capnmidnight/GeblinkenKiosk/doc/kiosk.JPG

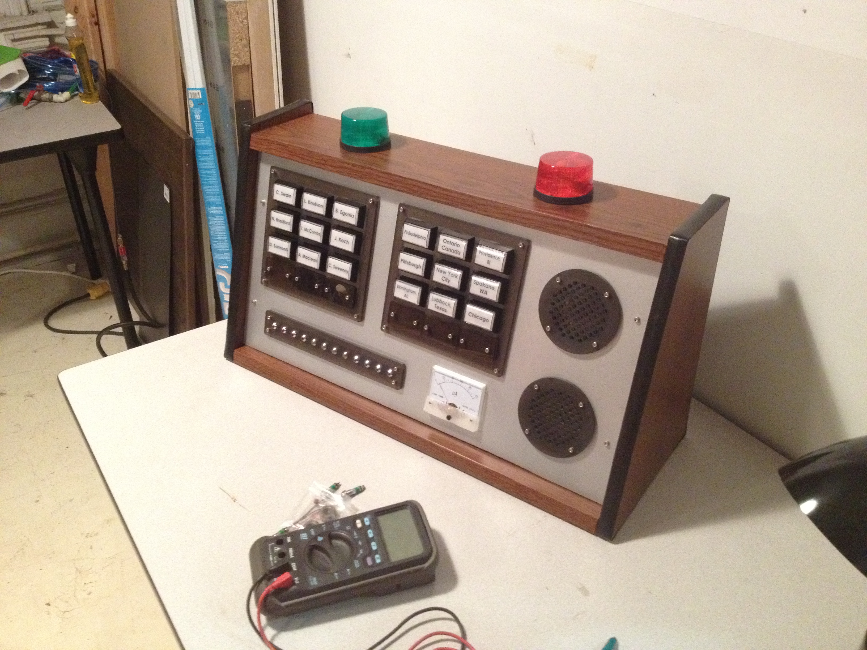
doc/kiosk.JPG
