capnmidnight/GeblinkenKiosk/doc/kiosk2.png

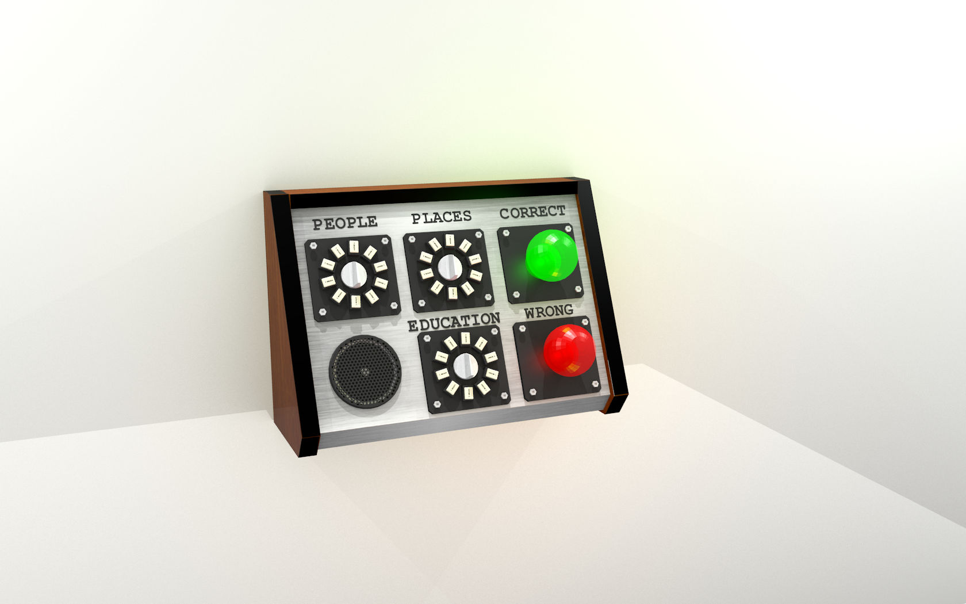
doc/kiosk2.png
