capnmidnight/GeblinkenKiosk/doc/kiosk1.png

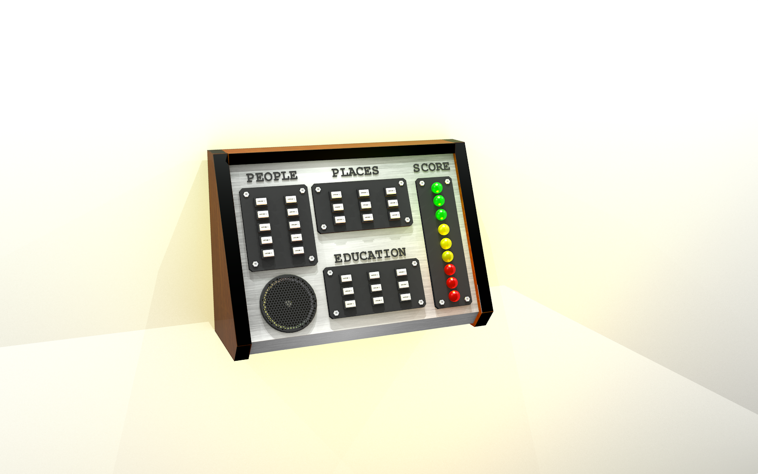
doc/kiosk1.png
