capnmidnight/GeblinkenKiosk/doc/kiosk3.png

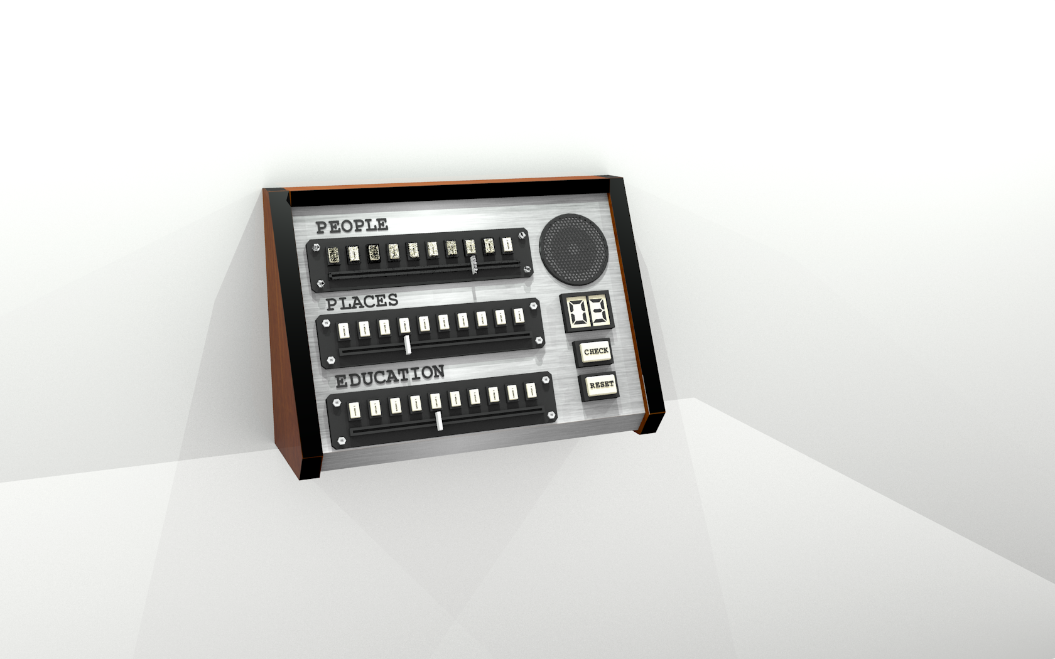
doc/kiosk3.png
