capnmidnight/GeblinkenKiosk/doc/mp3-kiosk.png

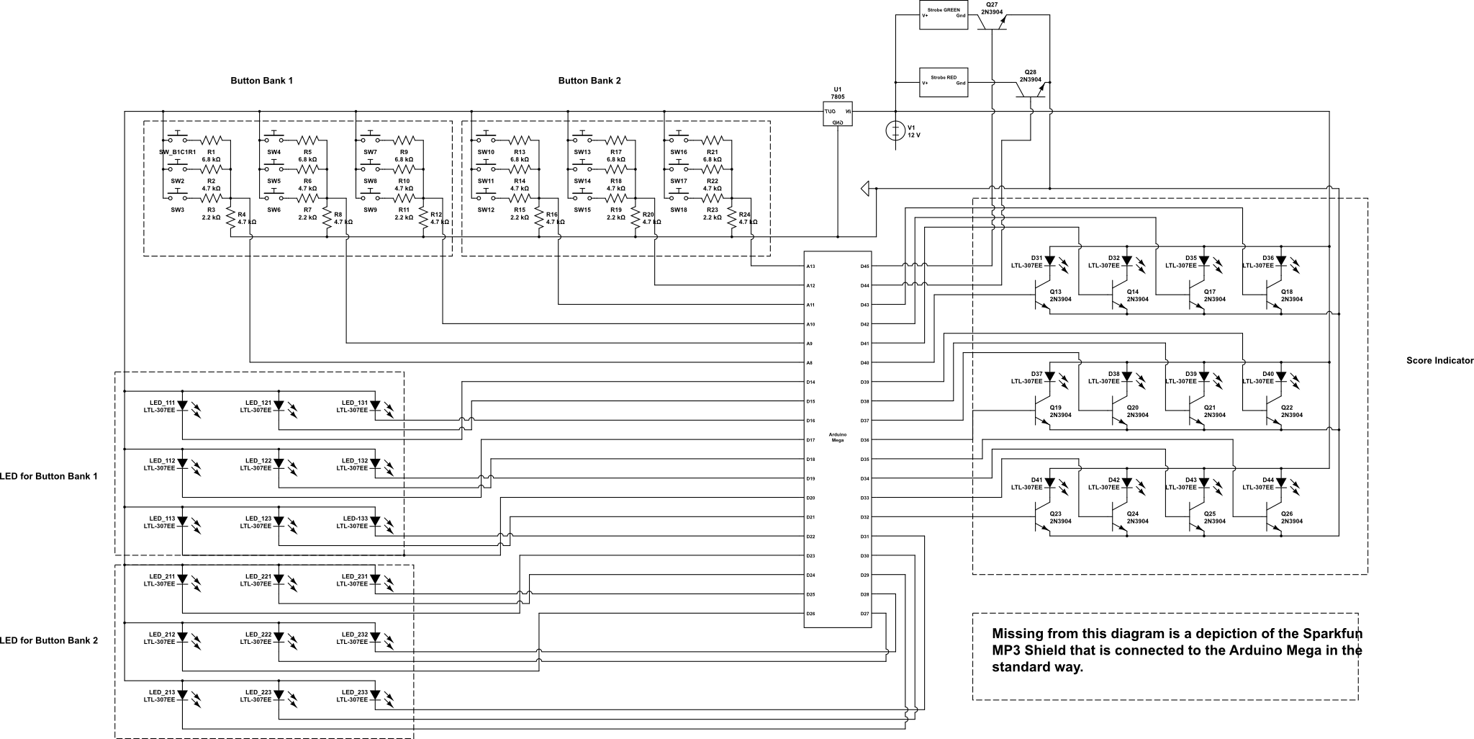
doc/mp3-kiosk.png
