capnmidnight/GeblinkenKiosk/(commit log)

2012-09-11 new audio files
    Deleted the old files on assumption that they aren't as high of quality.
    Also, new files have better file names.
    [Temple list.xlsx]
2012-09-11 a thing for testing the analog button encoder
2012-09-11 fixed the analog button decoder routine
    Ideal, calculated voltage values turned out to be slightly off from
    reality. Needed to reduce them by about 2%, which is pretty damn good
    considering the resistors were 10% resistors.
    [KioskSketchRedux.ino, TestButtons.ino]
2012-09-11 documentation
    circuit diagrams and an errata note on the SparkFun MP3 Player Shield.
2012-09-11 cleanup
    Removed MP3_DISABLE flag, as the problem is not with actually playing
    the MP3s. Moved the actual playing of the MP3s out of the FSM state
    handlers, under the idea that it would correct a memory leak, to no
    avail. However, I think I like it better this way anyway.
    [GeblinkenKiosk.ino, answer.cpp, answer.h, attract.cpp, attract.h, game_over.cpp, intro.cpp]
2012-09-11 analog button math
    a little math to show why the analog button encoder didn't work with the
    ideal numbers.
    [analog button encoder.xlsx]
2012-09-12 audio updates
    loaded the new audio files onto the SD card, with 8.3 character file
    names.
    [Temple list.xlsx]
2012-09-12 answer map in the track list
    [Temple list.xlsx]
2012-09-12 bug fixes and new button features
    [KioskSketchRedux.h, KioskSketchRedux.ino]
